Open-Visual-Stimulator/LED_driver/README.md

# LED_driver
a flexible led driving system

Currently testing for the following LEDs (this also serves as a mini database for LEDs being used with LightCrafters)  
UV - https://www.mouser.co.uk/ProductDetail/ams-OSRAM/LZ1-10UV0R-0000  
UV - https://uk.rs-online.com/web/p/uv-leds/2305352  

- Red LED - Roithner SMB1N-590-02 
- Green LED - Roithner SMB1N-D470-02
- Blue LED - Roithner SMB1N-420H-02
- UV LED - Osram LZ1-10UV0R-0000 (full package) or LZ1-00UV0R (LED only, no PCB)
