Open-Visual-Stimulator/LED_driver/board/board.step

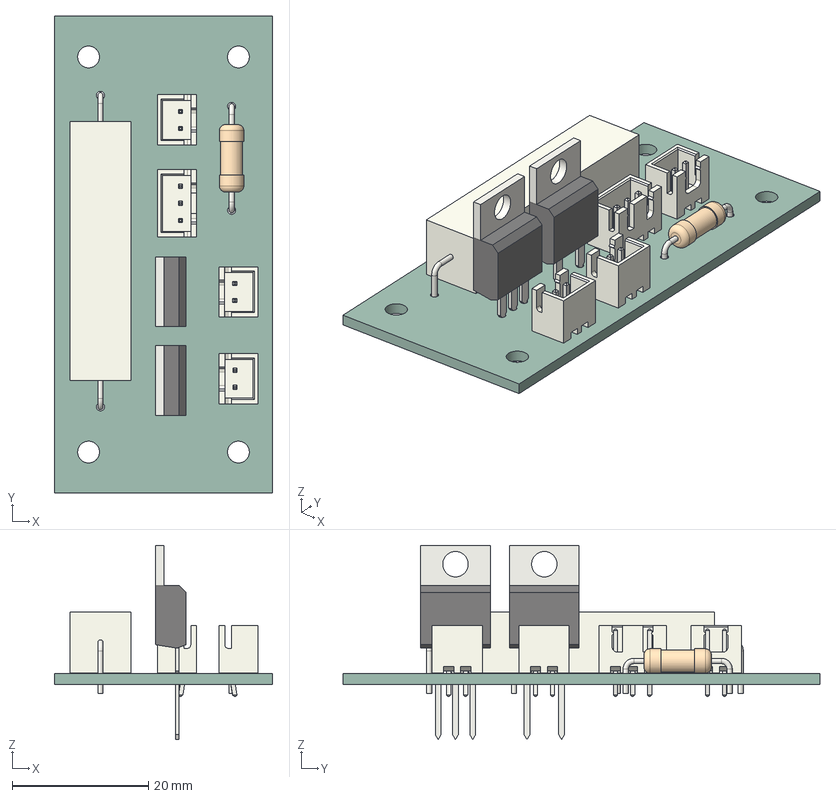
[picture p1: CAD file, 2025-02-04]
board/board.step
32.0 x 70.0 x 28.5 mm
JST_B3B_XH_A
TO-220-3_Vertical
R_Axial_Power_L380mm_W90mm_P4572mm
JST_B2B_XH_A x 3
R_Axial_DIN0414_L119mm_D45mm_P1524mm_Horizontal
TO-220-2_Vertical
R_Axial_DIN0411_L99mm_D36mm_P1524mm_Horizontal
_autosave-board_PCB
