Open-Visual-Stimulator/LED_driver/CAD/enclosure.FCStd

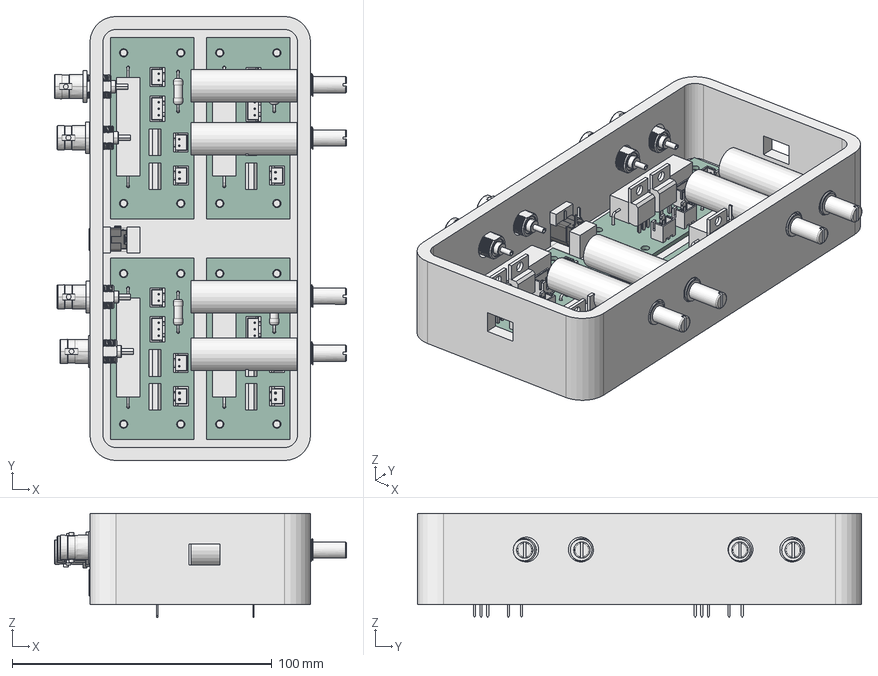
[picture p3: CAD file, 2025-02-04]
CAD/enclosure.FCStd
112.6 x 171.0 x 40.1 mm
JST_B3B_XH_A
TO-220-3_Vertical
R_Axial_Power_L380mm_W90mm_P4572mm
JST_B2B_XH_A
JST_B2B_XH_A001
R_Axial_DIN0414_L119mm_D45mm_P1524mm_Horizontal
TO-220-2_Vertical
JST_B2B_XH_A002
R_Axial_DIN0411_L99mm_D36mm_P1524mm_Horizontal
_autosave-board_PCB
JST_B3B_XH_A001
TO-220-3_Vertical002
R_Axial_Power_L380mm_W90mm_P4572mm001
JST_B2B_XH_A003
JST_B2B_XH_A004
R_Axial_DIN0414_L119mm_D45mm_P1524mm_Horizontal001
TO-220-2_Vertical002
JST_B2B_XH_A005
R_Axial_DIN0411_L99mm_D36mm_P1524mm_Horizontal001
_autosave-board_PCB001
JST_B3B_XH_A002
TO-220-3_Vertical004
R_Axial_Power_L380mm_W90mm_P4572mm002
JST_B2B_XH_A006
JST_B2B_XH_A007
R_Axial_DIN0414_L119mm_D45mm_P1524mm_Horizontal002
TO-220-2_Vertical004
JST_B2B_XH_A008
R_Axial_DIN0411_L99mm_D36mm_P1524mm_Horizontal002
_autosave-board_PCB002
JST_B3B_XH_A003
TO-220-3_Vertical006
R_Axial_Power_L380mm_W90mm_P4572mm003
JST_B2B_XH_A009
JST_B2B_XH_A010
R_Axial_DIN0414_L119mm_D45mm_P1524mm_Horizontal003
TO-220-2_Vertical006
JST_B2B_XH_A011
R_Axial_DIN0411_L99mm_D36mm_P1524mm_Horizontal003
_autosave-board_PCB003
DC Power Jack 5.5mm x 2.1mm
DC Power Jack 5.5mm x 2.1mm001
DC Power Jack 5.5mm x 2.1mm002
DC Power Jack 5.5mm x 2.1mm003
DC Power Jack 5.5mm x 2.1mm004
DC Power Jack 5.5mm x 2.1mm005
JL31106_BNC_FEMALE
JL31106_BNC_FEMALE001
JL31106_BNC_FEMALE002
JL31106_BNC_FEMALE003
Potentiometer021
Potentiometer022
Potentiometer044
Potentiometer066
