Open-Visual-Stimulator/LED_driver/single_led/365nm/AUV3-SQ32-0RT0K.stp

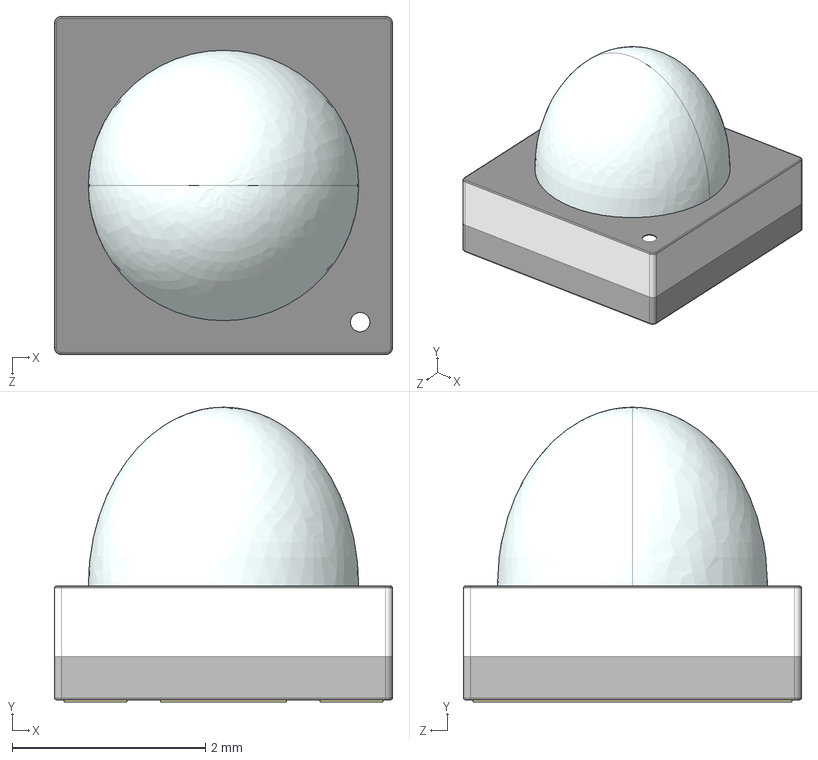
[picture p4: CAD file, 2025-02-04]
single_led/365nm/AUV3-SQ32-0RT0K.stp
3.50 x 3.05 x 3.50 mm
