Open-Visual-Stimulator/LED_driver/single_led/420nm/XEGAVT-H0-0000-000-000000K2001.stp

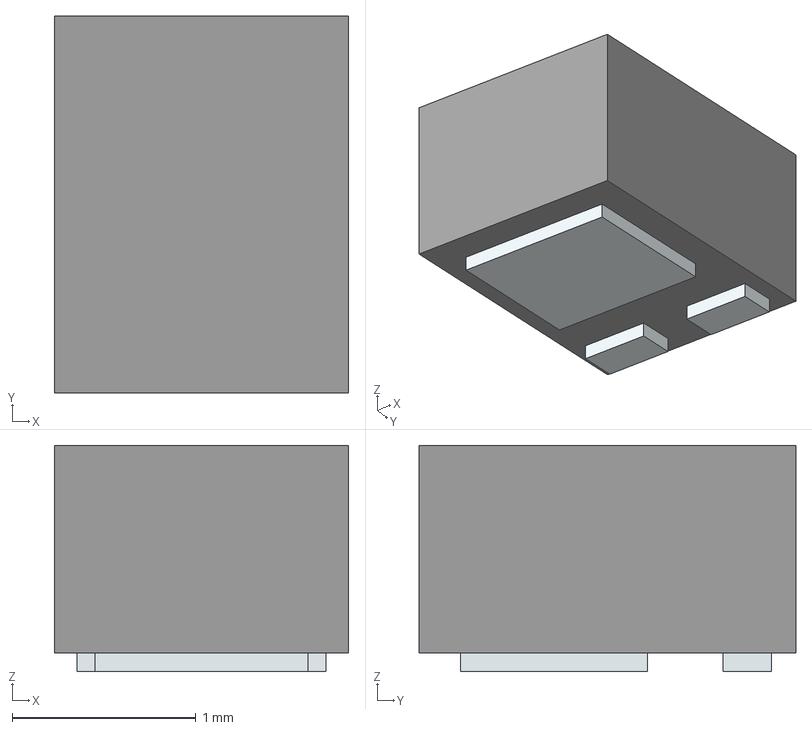
[picture p5: CAD file, 2025-02-04]
single_led/420nm/XEGAVT-H0-0000-000-000000K2001.stp
1.60 x 2.05 x 1.23 mm
Pins
