Open-Visual-Stimulator/LED_driver/single_led/590nm/LXM5-PL01.stp

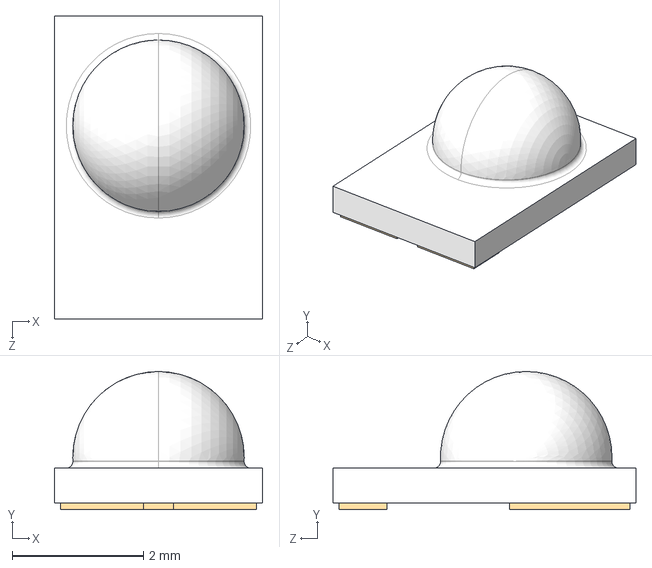
[picture p6: CAD file, 2025-02-04]
single_led/590nm/LXM5-PL01.stp
3.17 x 2.10 x 4.61 mm
