Open-Visual-Stimulator/LED_driver/single_led/625nm/XPEBRD-L1-0000-00902.stp

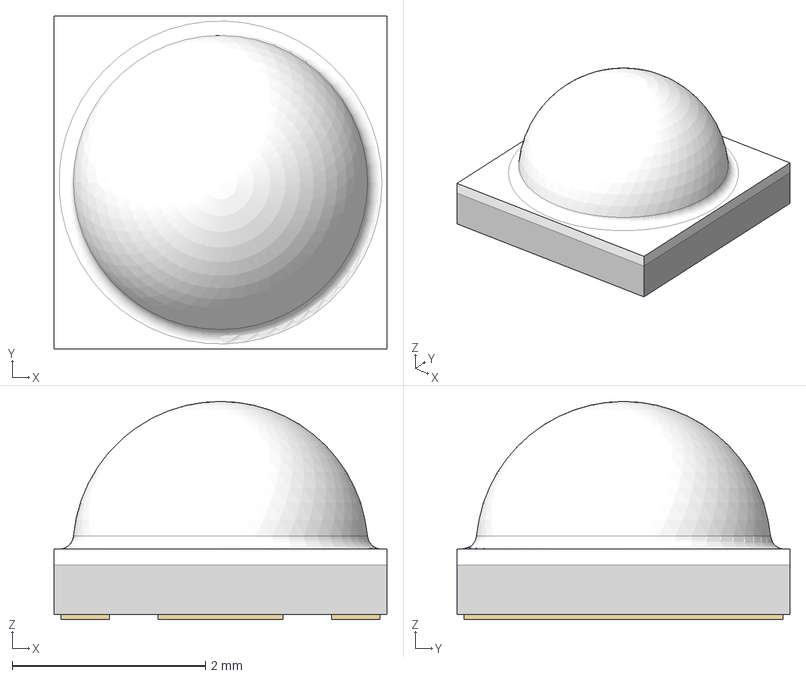
[picture p7: CAD file, 2025-02-04]
single_led/625nm/XPEBRD-L1-0000-00902.stp
3.45 x 3.45 x 2.26 mm
