Open-Visual-Stimulator/LED_driver/CAD/Lid.stl

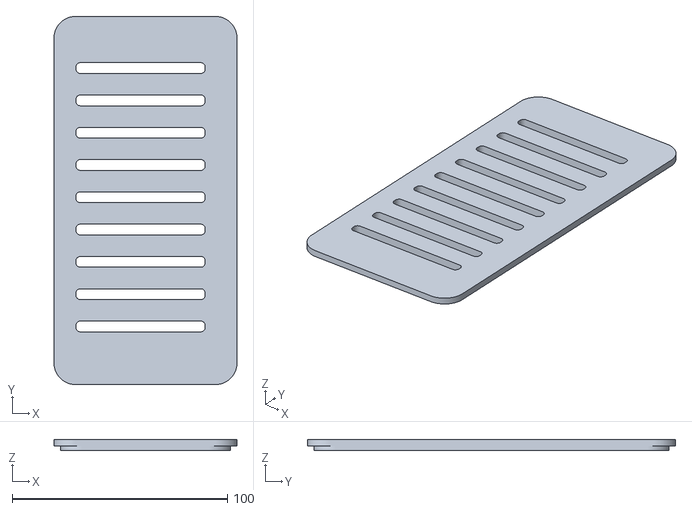
[picture p8: CAD file, 2025-02-04]
CAD/Lid.stl
85.0 x 171.0 x 5.00
