Open-Visual-Stimulator/LED_driver/(list of files, cad)

Other CAD files:
CAD/Enclosure.stl
single_led/365nm/AUV3-SQ32-0RT0K/Allegro/auv3sq320rt0k.psm
single_led/365nm/AUV3-SQ32-0RT0K/DEHDL/auv3_sq32_0rt0k/chips/chips.prt
single_led/420nm/XEGAVT-H0-0000-000-000000K2001/Allegro/xegavth00000000000000k2001.psm
single_led/420nm/XEGAVT-H0-0000-000-000000K2001/DEHDL/xegavt_h0_0000_000_000000k2001/chips/chips.prt
single_led/490nm/GV_QSSPA1.13-JZKZ-V1V6-1/Allegro/gvqsspa113jzkzv1v61.psm
single_led/490nm/GV_QSSPA1.13-JZKZ-V1V6-1/DEHDL/gv_qsspa1.13_jzkz_v1v6_1/chips/chips.prt
single_led/525nm/XQEGRN-00-0000-000000B02/Allegro/xqegrn000000000000b02.psm
single_led/525nm/XQEGRN-00-0000-000000B02/DEHDL/xqegrn_00_0000_000000b02/chips/chips.prt
single_led/625nm/XPEBRD-L1-0000-00902/Allegro/xpebrdl1000000902.psm
single_led/625nm/XPEBRD-L1-0000-00902/DEHDL/xpebrd_l1_0000_00902/chips/chips.prt
