Open-Visual-Stimulator/LED_driver/(list of files, drawings)

Other design files:
single_led/365nm/AUV3-SQ32-0RT0K/Altium/AUV3-SQ32-0RT0K.SchLib
single_led/365nm/AUV3-SQ32-0RT0K/Altium/AUV3SQ320RT0K.PcbLib
single_led/490nm/GV_QSSPA1.13-JZKZ-V1V6-1/Altium/GV_QSSPA1.13-JZKZ-V1V6-1.SchLib
single_led/490nm/GV_QSSPA1.13-JZKZ-V1V6-1/Altium/GVQSSPA113JZKZV1V61.PcbLib
single_led/625nm/XPEBRD-L1-0000-00902/Altium/XPEBRD-L1-0000-00902.SchLib
single_led/625nm/XPEBRD-L1-0000-00902/Altium/XPEBRDL1000000902.PcbLib
