Open-Visual-Stimulator/LED_driver/legacy/board/board.kicad_pcb

## KiCad design legacy/board/board.kicad_pcb (2024-02-02, an earlier design)

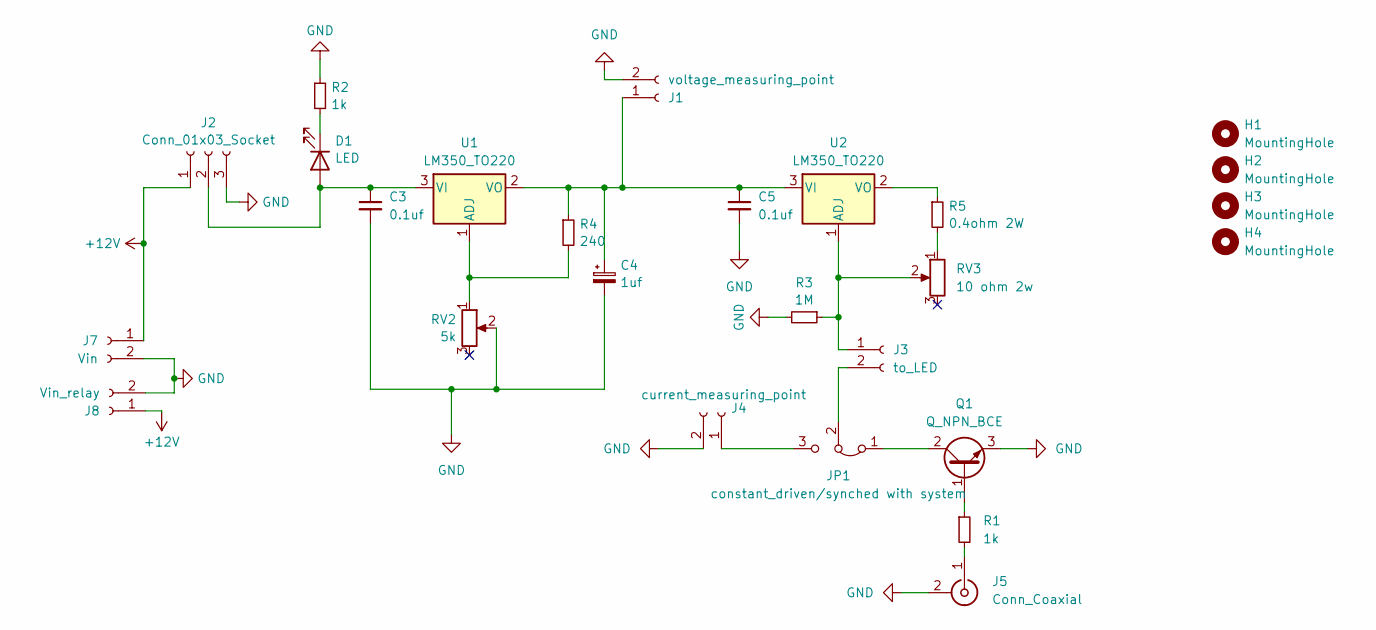
[picture p11: schematic board.kicad_sch]

Parts:
C3, C5: 0.1uf; C_Disc_D9.0mm_W2.5mm_P5.00mm
C4: 1uf; CP_Radial_D10.0mm_P5.00mm
D1: LED; LED_D5.0mm_Clear
H1, H2, H3, H4: MountingHole; MountingHole_3.2mm_M3
J1: voltage_measuring_point; JST_XH_B2B-XH-A_1x02_P2.50mm_Vertical
J2: Conn_01x03_Socket; JST_XH_B3B-XH-A_1x03_P2.50mm_Vertical
J3: to_LED; JST_XH_B2B-XH-A_1x02_P2.50mm_Vertical
J4: current_measuring_point; JST_XH_B2B-XH-A_1x02_P2.50mm_Vertical
J5: Conn_Coaxial; JST_XH_B2B-XH-A_1x02_P2.50mm_Vertical
J7: Vin; JST_XH_B2B-XH-A_1x02_P2.50mm_Vertical
J8: Vin_relay; JST_XH_B2B-XH-A_1x02_P2.50mm_Vertical
JP1: constant_driven/synched with system; PinHeader_1x03_P2.54mm_Vertical
Q1: Q_NPN_BCE; TO-220-3_Vertical
R1, R2: 1k; R_Axial_DIN0411_L9.9mm_D3.6mm_P15.24mm_Horizontal
R3: 1M; R_Axial_DIN0411_L9.9mm_D3.6mm_P15.24mm_Horizontal
R4: 240; R_Axial_DIN0411_L9.9mm_D3.6mm_P15.24mm_Horizontal
R5: 0.4ohm 2W; R_Axial_DIN0411_L9.9mm_D3.6mm_P15.24mm_Horizontal
RV2: 5k; PinHeader_1x03_P2.54mm_Vertical
RV3: 10 ohm 2w; PinHeader_1x03_P2.54mm_Vertical
U1, U2: LM350_TO220; TO-220-3_Vertical

Connections:
+12V: J2.1, J7.1, J8.1
GND: C3.2, C4.2, C5.2, J1.2, J2.3, J4.2, J5.2 (Ext), J7.2, J8.2, Q1.3 (E), R2.1, R3.2, RV2.2
unnamed: C3.1, D1.2 (A), J2.2, U1.3 (VI)
unnamed: D1.1 (K), R2.2
unnamed: C4.1, C5.1, J1.1, R4.1, U1.2 (VO), U2.3 (VI)
unnamed: J3.1, R3.1, RV3.2, U2.1 (ADJ)
unnamed: J3.2, JP1.2 (C)
unnamed: J4.1, JP1.3 (B)
unnamed: J5.1 (In), R1.2
unnamed: JP1.1 (A), Q1.2 (C)
unnamed: Q1.1 (B), R1.1
unnamed: R5.2, RV3.1
unnamed: R4.2, RV2.1, U1.1 (ADJ)
unnamed: R5.1, U2.2 (VO)

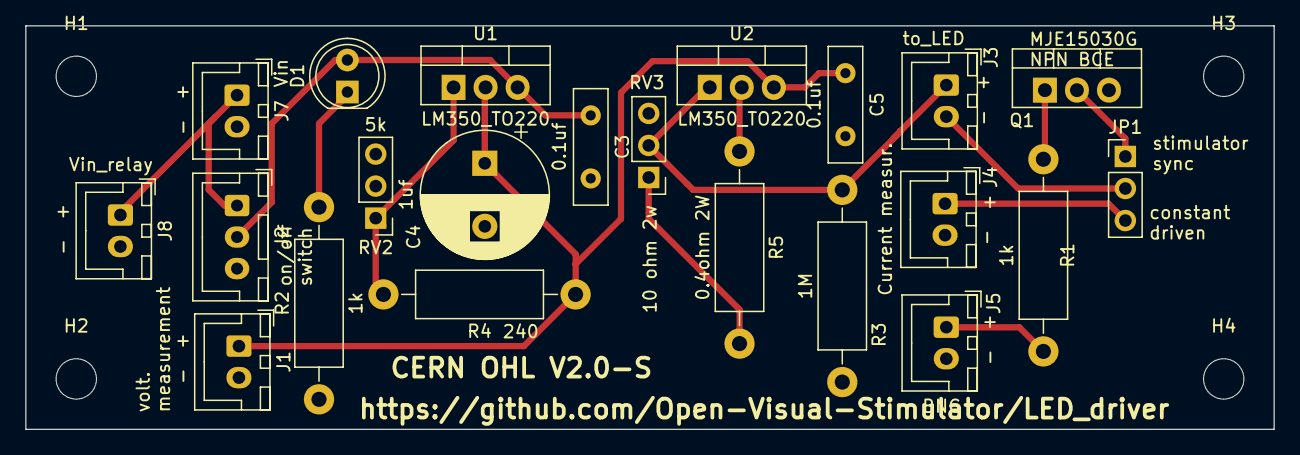
[picture p12: board legacy/board/board.kicad_pcb from above]

Board: 2 copper layers, 99.0 x 32.0 mm, 26 parts (0 on the bottom side), 14 nets.
