Open-Visual-Stimulator/LED_driver/led_holder/led_holder.kicad_pcb

## KiCad design led_holder/led_holder.kicad_pcb (2023-12-12)

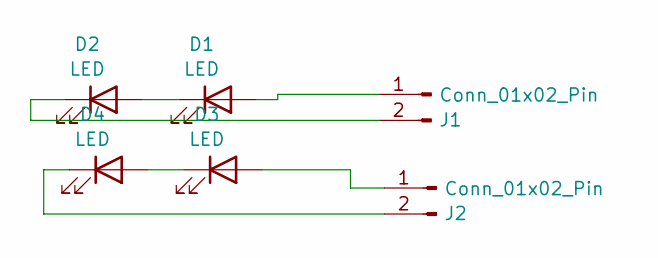
[picture p13: schematic led_holder.kicad_sch]

Parts:
D1, D2, D3, D4: LED; LED_Cree-XHP35
J1, J2: Conn_01x02_Pin; JST_XH_B2B-XH-A_1x02_P2.50mm_Vertical

Connections:
unnamed: D1.2 (A), J1.1
unnamed: D1.1 (K), D2.2 (A)
unnamed: D2.1 (K), J1.2
unnamed: D3.2 (A), J2.1
unnamed: D3.1 (K), D4.2 (A)
unnamed: D4.1 (K), J2.2

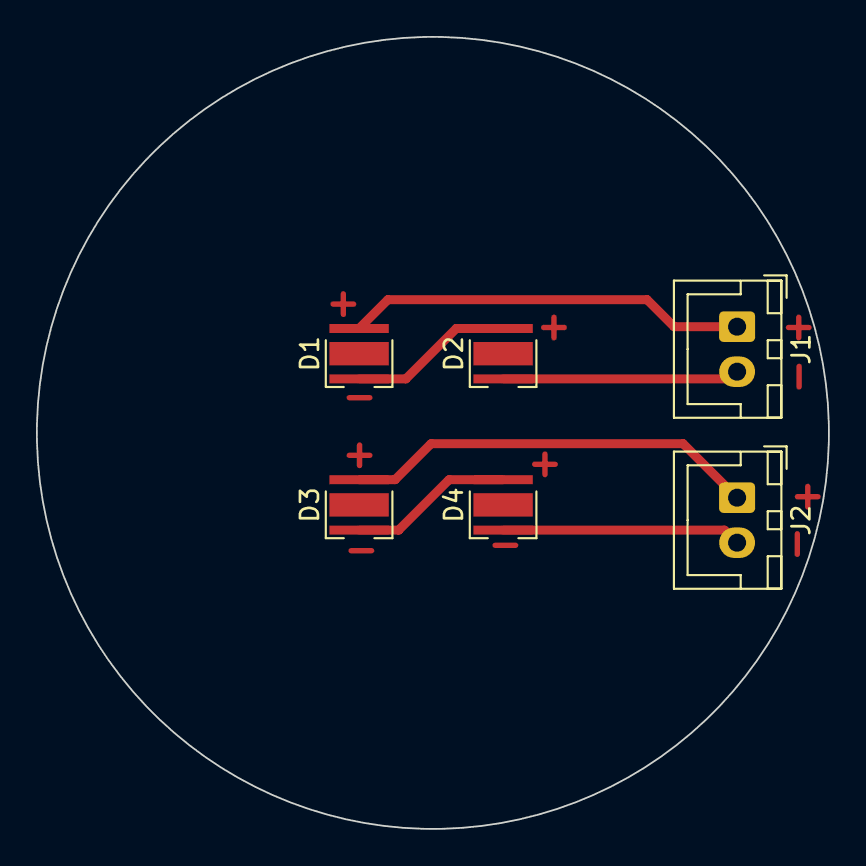
[picture p14: board led_holder.kicad_pcb from above]

Board: 2 copper layers, 44.0 x 44.0 mm, 6 parts (0 on the bottom side), 6 nets.
