Open-Visual-Stimulator/LED_driver/(commit log)

2023-12-06 initial schematic
    [board.kicad_pcb, board.kicad_sch]
2023-12-06 add link on schematic
    [board.kicad_sch]
2023-12-12 create first test for UV led holder/pcb
    [led_holder-B_Adhesive.gbr, led_holder-B_Courtyard.gbr, led_holder-B_Cu.gbr, led_holder-B_Fab.gbr, led_holder-B_Mask.gbr, led_holder-B_Paste.gbr, led_holder-B_Silkscreen.gbr, led_holder-Edge_Cuts.gbr]
2023-12-13 add first schematci version of LED driver
    [board.kicad_pcb, board.kicad_sch]
2023-12-13 make first prototype and production files
    [board.kicad_pcb, board.kicad_sch, bom.csv, designators.csv, positions.csv]
2024-02-02 add some missing labels
    [board.kicad_pcb]
2025-01-15 new design for led Driver
    [board.kicad_pcb, board.kicad_sch, bom.csv, designators.csv, positions.csv]
2025-01-15 add more resistor footprints so that it is easier to manage the board for different current/power levels
    [board.kicad_pcb, bom.csv, designators.csv, positions.csv]
2025-01-15 save small design changes just descriobed
    [board.kicad_pcb, board.kicad_sch]
2025-02-04 CAD and single_led files
    [AUV3-SQ32-0RT0K.SchLib, AUV3-SQ32-0RT0K.stp, AUV3SQ320RT0K.PcbLib, EDI2CAP.CFG, Enclosure.stl, GVQSSPA113JZKZV1V61.PcbLib, GV_QSSPA1.13-JZKZ-V1V6-1.SchLib, GV_QSSPA1.13-JZKZ-V1V6-1.stp]
2025-10-31 add infor on 365 led PCB
2026-02-07 Revise LED entries in README
    Updated LED listings with new part numbers and sources.
