Open-Visual-Stimulator/LED_driver/(notices)

Notices in the files:
legacy/board/board.kicad_pcb:
CERN OHL V2.0-S
board/board.kicad_pcb:
CERN OHL S V2
